Luan-Don/AD5941-EIT-Analyzer/README.md

# AD5941-EIT-Analyzer
This project is based on the previous project "AD5941 Impedance Analyzer" which extends further its application in Electrical Impedance Tomography. This project focuses on making the external PCB board (containing MUX) for AD5941 Impedance Analyzer (AIA for short).
