Luan-Don/AD5941-EIT-Analyzer/docs/weekly_report/AIA_w1.pptx

## MUX Circuit for Electrical Impedance Tomography (EIT) System

Weekly report – W1

## System overview

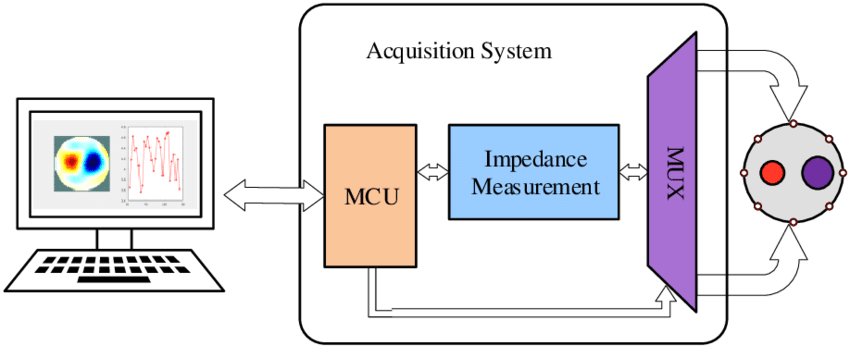
[picture p1: figure]
The block diagram of electrical impedance tomography (EIT) system ...

Fig 1. Block diagram of Electrical impedance tomography (EIT) system (5)

Notes: Mainly consists of 3 main parts: Acquisition system, phantom, host system
Acquisition system includes an MCU, an impedance measurement module and multiplexer circuit.

## Drive pattern: 4-wire measurement using AD5941

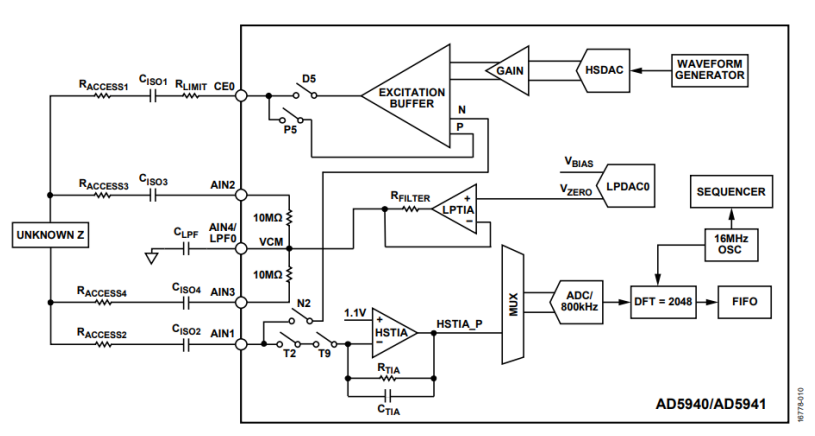
[picture p2: figure]
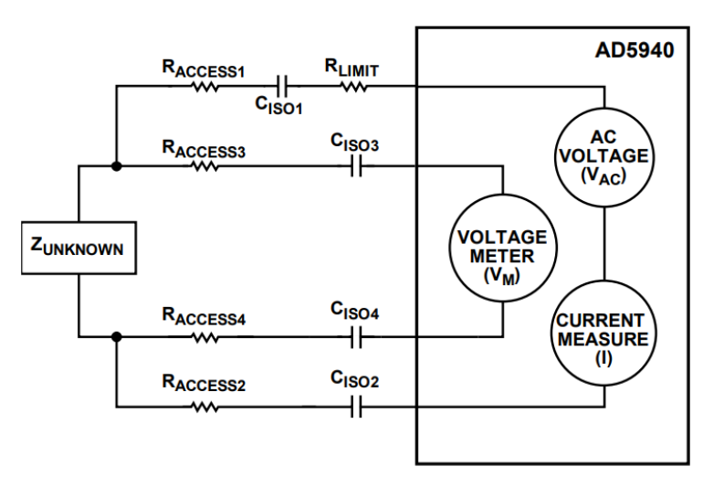
[picture p3: figure]

## Multiplexer (MUX) circuit

-> Require 4 MUX as analog switches

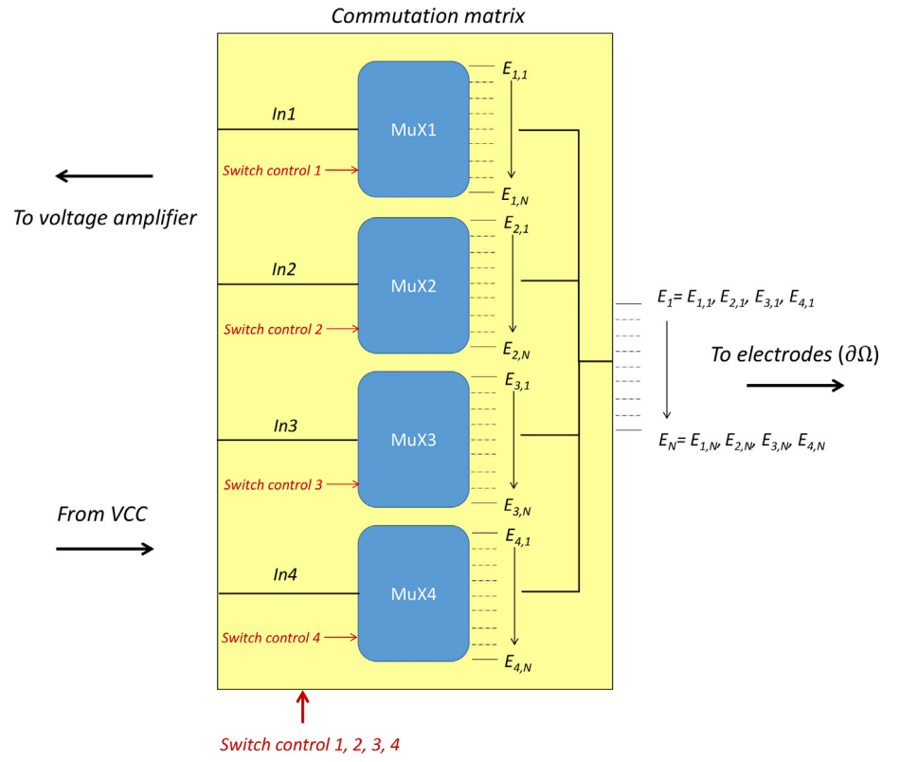
[picture p4: figure]

Controlled by Arduino Mega (4)
ADG506AKRZ – 16 channel
Switching time: <1us

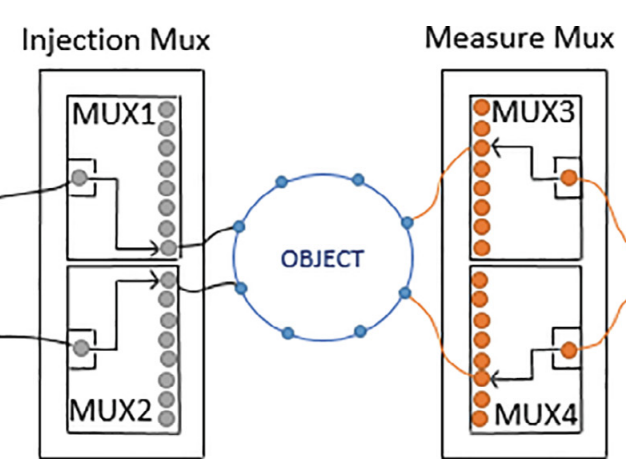
[picture p5: figure]

Controlled by Arduino Mega (1)
74HC4067 – 8 channel

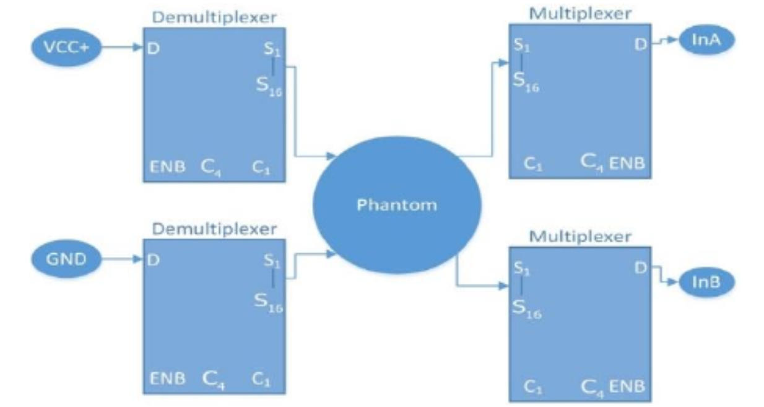
[picture p6: figure]

Controlled by Raspberry Pi (2)
ADG506AKNZ – 16 channel
1ms/data -> 4s/measurement

Notes: 100us

## 4 Current injection methods - Neighboring

Red: current electrodes
Blue: voltage electrodes

the differential potentials are measured across the different electrodes, excluding the current electrodes

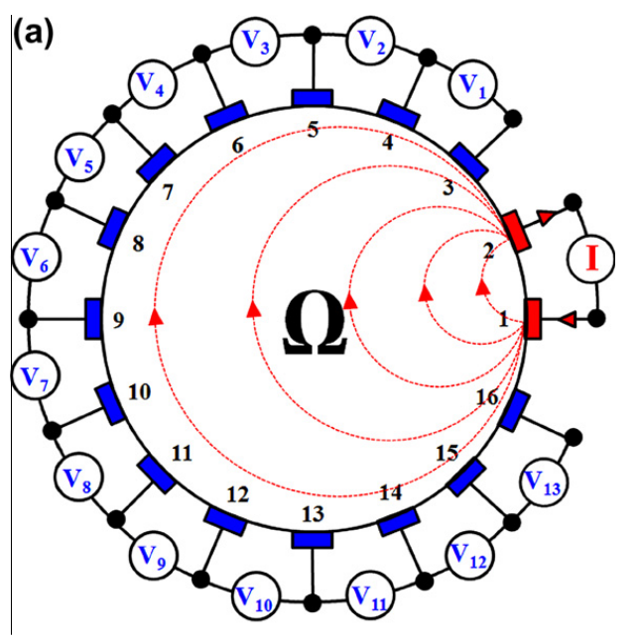
[picture p7: figure]
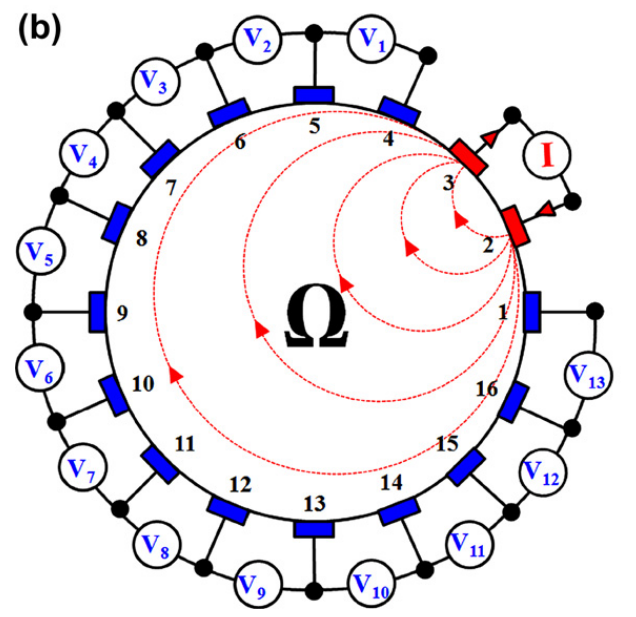
[picture p8: figure]

208 voltage measurement
104 independent data

## 4 Current injection methods - Opposite

Red: current electrodes
Blue: voltage electrodes

Differential potentials are measured on the voltage electrodes with respect to the electrode (called as the voltage reference electrode) adjacent to the current-injecting electrode.

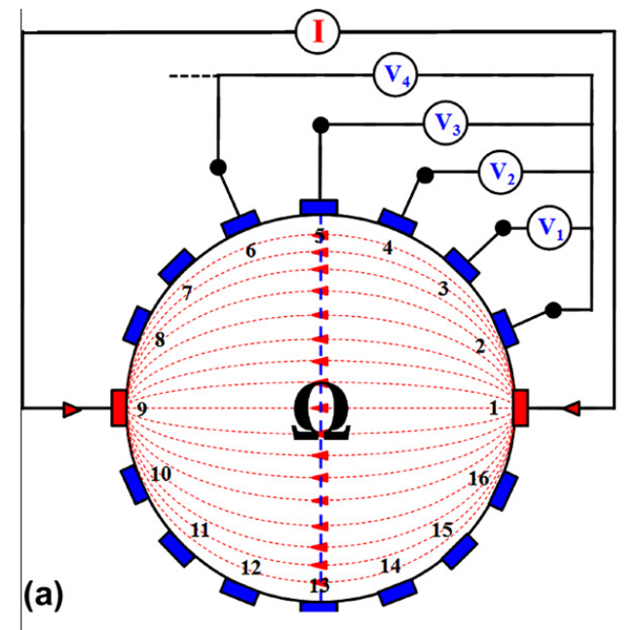
[picture p9: figure]

208 voltage measurement
104 independent data

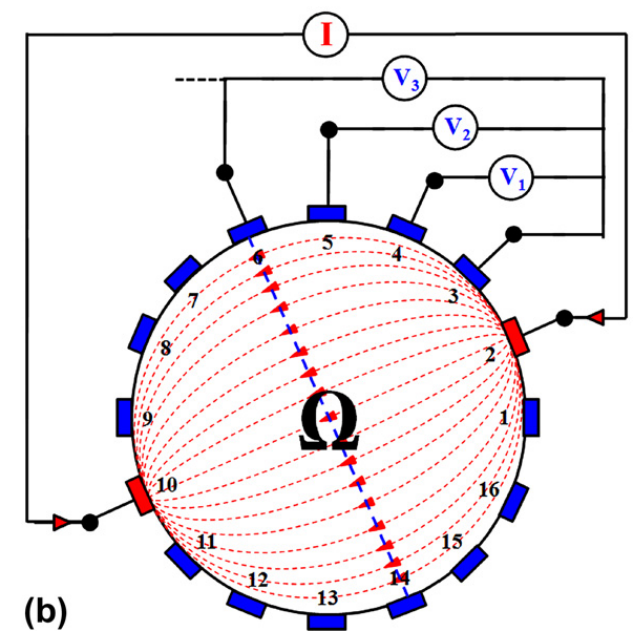
[picture p10: figure]

current distribution is more uniform and, therefore, has a good sensitiviy

## 4 Current injection methods - Cross

Red: current electrodes
Blue: voltage electrodes

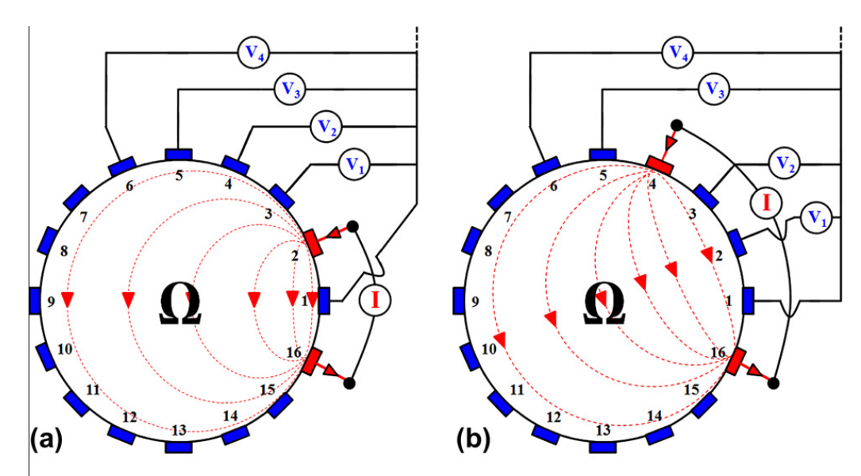
[picture p11: figure]
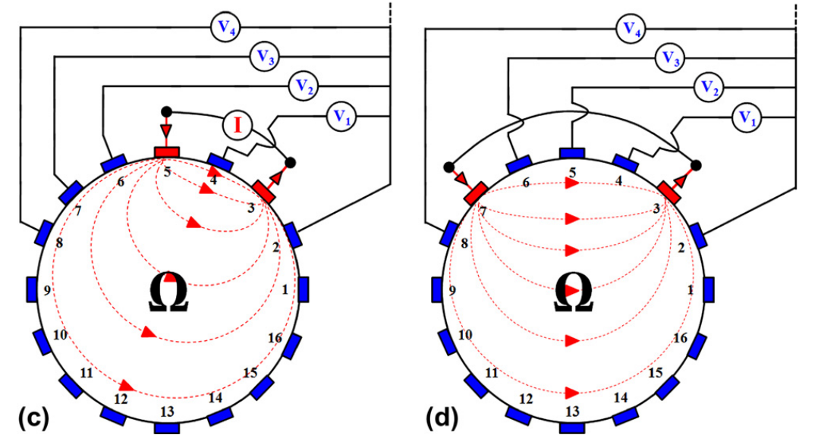
[picture p12: figure]

182 voltage measurement
104 independent data

Does not have as good a sensitivity in the periphery as does the neighboring method, but has better sensitivity over the entire domain under test

## 4 Current injection methods - Adaptive

Red: current electrodes
Blue: voltage electrodes

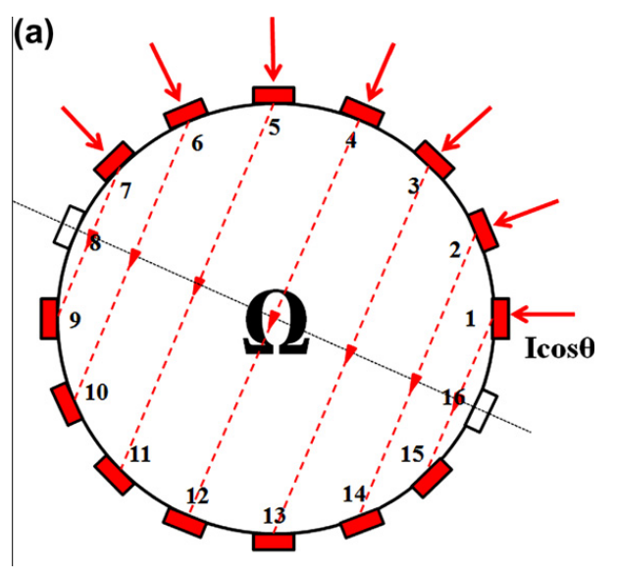
[picture p13: figure]

the boundary potentials are measured with respect to a single grounded electrode

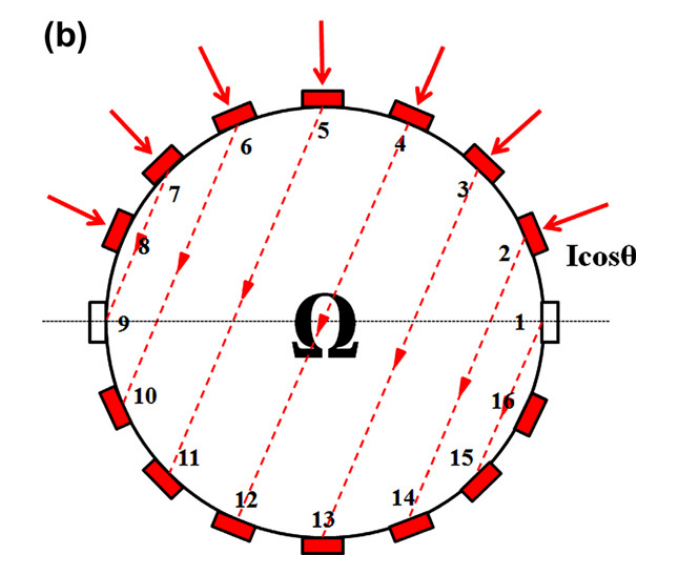
[picture p14: figure]

102 independent data

## Future planning

- Research more about the speed for data acquisition -> to select MUX and MCU to control the MUX

## Reference

- https://www.sciencedirect.com/science/article/pii/S2468067222000190 (https://www.researchgate.net/publication/334773554_Design_of_low-cost_and_high-speed_portable_two-dimensional_electrical_impedance_tomography_EIT)
- ( (https://www.researchgate.net/publication/334773554_Design_of_low-cost_and_high-speed_portable_two-dimensional_electrical_impedance_tomography_EIT)PDF) Design of low-cost and high-speed portable two-dimensional electrical impedance tomography (EIT) (researchgate.net (https://www.researchgate.net/publication/334773554_Design_of_low-cost_and_high-speed_portable_two-dimensional_electrical_impedance_tomography_EIT)) (https://www.researchgate.net/publication/334773554_Design_of_low-cost_and_high-speed_portable_two-dimensional_electrical_impedance_tomography_EIT)
- Studying the resistivity imaging of chicken tissue phantoms with different current patterns in Electrical Impedance Tomography (EIT) (https://www.sciencedirect.com/science/article/pii/S0263224112000036)– (https://www.sciencedirect.com/science/article/pii/S0263224112000036)ScienceDirect (https://www.sciencedirect.com/science/article/pii/S0263224112000036)
- An open-source and easily replicable hardware for Electrical Impedance Tomography (https://www.sciencedirect.com/science/article/pii/S2468067222000232)– (https://www.sciencedirect.com/science/article/pii/S2468067222000232)ScienceDirect (https://www.sciencedirect.com/science/article/pii/S2468067222000232)
- Deep learning scheme (https://www.researchgate.net/publication/350287658_Deep_learning_scheme_PSPNet_for_electrical_impedance_tomography)PSPNet (https://www.researchgate.net/publication/350287658_Deep_learning_scheme_PSPNet_for_electrical_impedance_tomography) for electrical impedance tomography (researchgate.net) (https://www.researchgate.net/publication/350287658_Deep_learning_scheme_PSPNet_for_electrical_impedance_tomography)

## Microcontroller - Requirement

- Have enough GPIO pins to control 4 muxes
Each mux requires 4 control pins (INH, A, B, C) -> Require at least 16 pins + 2 pins for I2C communication
- Have I2C communication
- Low-cost

Notes: Toc do i2c
