Luan-Don/AD5941-EIT-Analyzer/docs/weekly_report/AIA_w3.pptx

## MUX Circuit for Electrical Impedance Tomography (EIT) System

Weekly report – W3

## System overview

The block diagram of electrical impedance tomography (EIT) system ...

Fig 1. Block diagram of Electrical impedance tomography (EIT) system (5)

Notes: Mainly consists of 3 main parts: Acquisition system, phantom, host system
Acquisition system includes an MCU, an impedance measurement module and multiplexer circuit.

## Drive pattern: 4-wire measurement using AD5941

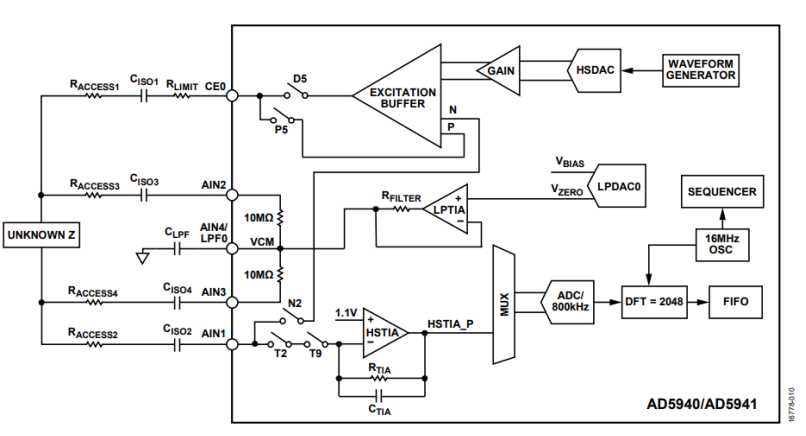
[picture p15: figure]

Accuracy of measured impedance relies on
R_(ACCESS1) , R_(ACCESS2) but not on R_(ACCESS3) , R_(ACCESS4)
- Use HIGH ON-RESISTANCE MUX at voltage electrode (Higher availability, lower cost)
- Use LOW ON-RESISTANCE MUX at current electrode


## Market research

| ADG706BRUZ | CD4067BE | NX3L4051PW-Q100J
MUX circuit | 16:1 | 16:1 | 8:1
Ron (max) | 4.5 Ω | 240 Ω | 0.75 Ω
Δ Ron between channel (max) | | 5 Ω | 0.07 Ω
Switch time (Ton, Toff) | 32ns, 16ns | | 45ns, 25ns
Bandwidth | 25MHz | 14MHz | 15MHz
Price | $105 | $22 (available at our lab) | $23
Delivery day | 14 days | | 21 days
Online store | ADG706BRUZ (ruten.com.tw) (https://www.ruten.com.tw/item/show?22410942692506) | | NX3L4051PW-Q100J (ruten.com.tw) (https://www.ruten.com.tw/item/show?22339779695833)
Datasheet | ADG706/ADG707 (Rev. B) (analog.com) (https://www.analog.com/media/en/technical-documentation/data-sheets/ADG706_707.pdf) | CD40x7B CMOS (https://www.ti.com/lit/ds/symlink/cd4067b.pdf?HQS=dis-dk-null-digikeymode-dsf-pf-null-wwe&ts=1723042470805)Analog (https://www.ti.com/lit/ds/symlink/cd4067b.pdf?HQS=dis-dk-null-digikeymode-dsf-pf-null-wwe&ts=1723042470805) (https://www.ti.com/lit/ds/symlink/cd4067b.pdf?HQS=dis-dk-null-digikeymode-dsf-pf-null-wwe&ts=1723042470805)Multiplexers (https://www.ti.com/lit/ds/symlink/cd4067b.pdf?HQS=dis-dk-null-digikeymode-dsf-pf-null-wwe&ts=1723042470805) or (https://www.ti.com/lit/ds/symlink/cd4067b.pdf?HQS=dis-dk-null-digikeymode-dsf-pf-null-wwe&ts=1723042470805)Demultiplexers (http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 | Single low-ohmic 8-channel analog switch (nxp.com) (https://www.nxp.com/docs/en/data-sheet/NX3L4051.pdf)

## Proposed design: 16-electrode EIT system

Proposed MUX solution:
- 2 1:16 mux, 2 low Ron 1:8 mux
- Cross method, combine both neighboring and opposite method

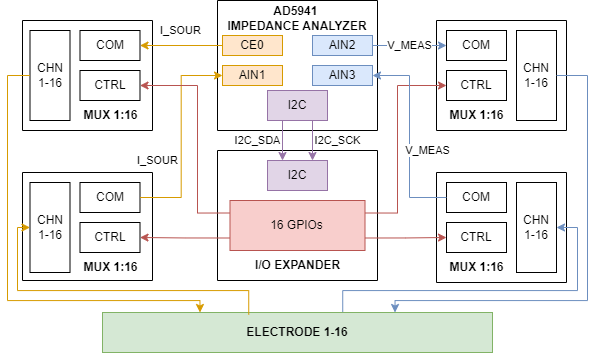
[picture p16: figure]
Ảnh có chứa văn bản, biểu đồ, Kế hoạch, ảnh chụp màn hình Mô tả được tạo tự động

Common MUX solution:
- 4 1:16 mux
- Neighboring method [1,2,3]

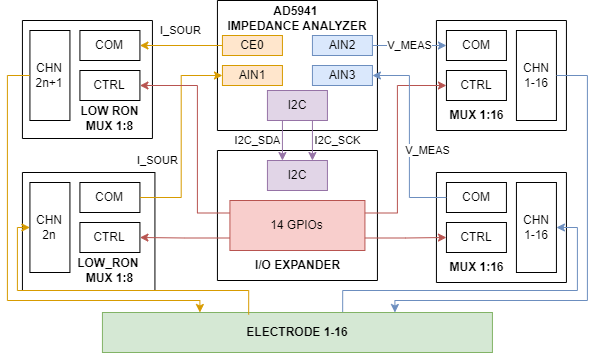
[picture p17: figure]
Ảnh có chứa văn bản, biểu đồ, Kế hoạch, ảnh chụp màn hình Mô tả được tạo tự động

## Current injection – Neighboring method

Red: current electrodes
Blue: voltage electrodes

the differential potentials are measured across the different electrodes, excluding the current electrodes


208 voltage measurement
104 independent data

## Current injection – Opposite method

Red: current electrodes
Blue: voltage electrodes

Differential potentials are measured on the voltage electrodes with respect to the electrode (called as the voltage reference electrode) adjacent to the current-injecting electrode.


208 voltage measurement
104 independent data


current distribution is more uniform and, therefore, has a good sensitivity

## Current injection – Cross method

Adjacent electrodes E16 and E1 are first selected for current and voltage reference electrodes. The 13 voltage data are measured successively for all other 13 electrodes starting from E3. The next 13 voltage data are obtained by injecting by injecting the positive current through E4, keeping E16 as the current reference. The cycle repeats with E3 and E2 as current and voltage reference electrodes.


Red: current electrodes
Blue: voltage electrodes

182 voltage measurement
104 independent data

Does not have as good a sensitivity in the periphery as does the neighboring method, but has better sensitivity over the entire domain under test

## Current injection – Another cross method

Red: current electrodes

Odd-number electrodes are selected for the positive current-injecting electrode (CE0) while even-number electrodes are selected for the negative current-injecting electrode (AIN1). This method requires two 1:8 mux to drive the current electrodes, unlike other method with two 1:16 mux.

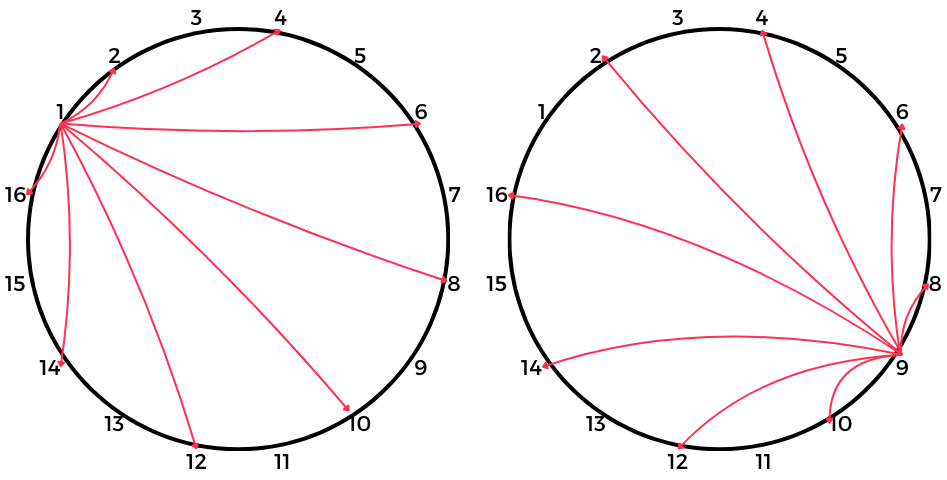
[picture p18: figure]
Ảnh có chứa biểu đồ, vòng tròn, hàng Mô tả được tạo tự động

8 x 16 x 13 = 1664 voltage measurement

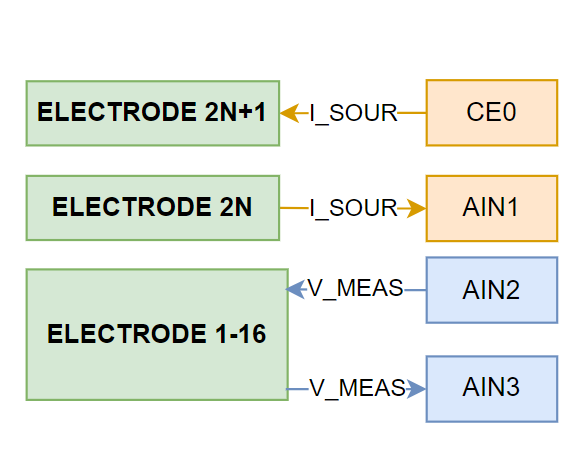
[picture p19: figure]

- Good sensitivity measuring peripheral impedance
- Uniform current distribution

## Proposed schematics

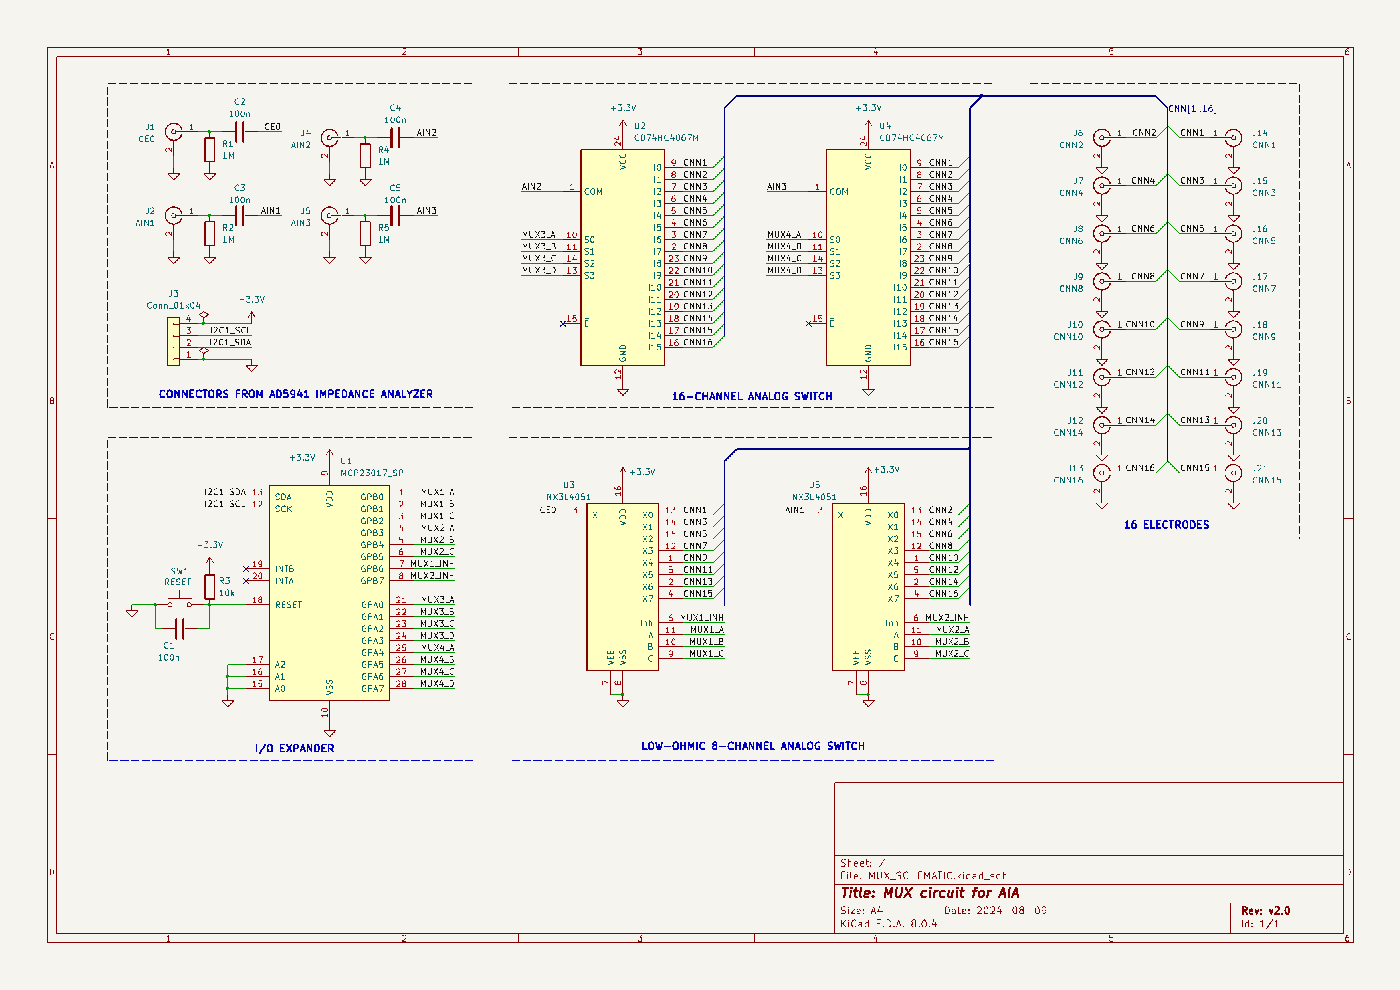
[picture p20: figure]

## Future planning

## Reference

- (PDF) Design of low-cost and high-speed portable two-dimensional electrical impedance tomography (EIT) (researchgate.net) (https://www.researchgate.net/publication/334773554_Design_of_low-cost_and_high-speed_portable_two-dimensional_electrical_impedance_tomography_EIT)
- Studying the resistivity imaging of chicken tissue phantoms with different current patterns in Electrical Impedance Tomography (EIT) – (https://www.sciencedirect.com/science/article/pii/S0263224112000036)ScienceDirect (https://www.sciencedirect.com/science/article/pii/S0263224112000036)
- An open-source and easily replicable hardware for Electrical Impedance Tomography – (https://www.sciencedirect.com/science/article/pii/S2468067222000232)ScienceDirect (https://www.sciencedirect.com/science/article/pii/S2468067222000232)
- Deep learning scheme (https://www.researchgate.net/publication/350287658_Deep_learning_scheme_PSPNet_for_electrical_impedance_tomography)PSPNet (https://www.researchgate.net/publication/350287658_Deep_learning_scheme_PSPNet_for_electrical_impedance_tomography) for electrical impedance tomography (researchgate.net) (https://www.researchgate.net/publication/350287658_Deep_learning_scheme_PSPNet_for_electrical_impedance_tomography)

## Microcontroller - Requirement

- Have enough GPIO pins to control 4 muxes
Each mux requires 4 control pins (INH, A, B, C) -> Require at least 16 pins + 2 pins for I2C communication
- Have I2C communication
- Low-cost

Notes: Toc do i2c
