Luan-Don/AD5941-EIT-Analyzer/hardware/signal_diagram/2nddesign_new_method_electrode_connection.png

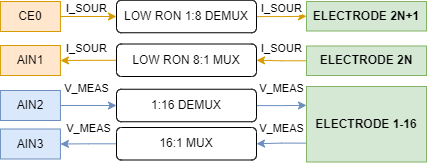
hardware/signal_diagram/2nddesign_new_method_electrode_connection.png
