Luan-Don/AD5941-EIT-Analyzer/hardware/mux_schematic_kicad/MUX_SCHEMATIC.kicad_pcb

## KiCad design hardware/mux_schematic_kicad/MUX_SCHEMATIC.kicad_pcb (2024-07-30)

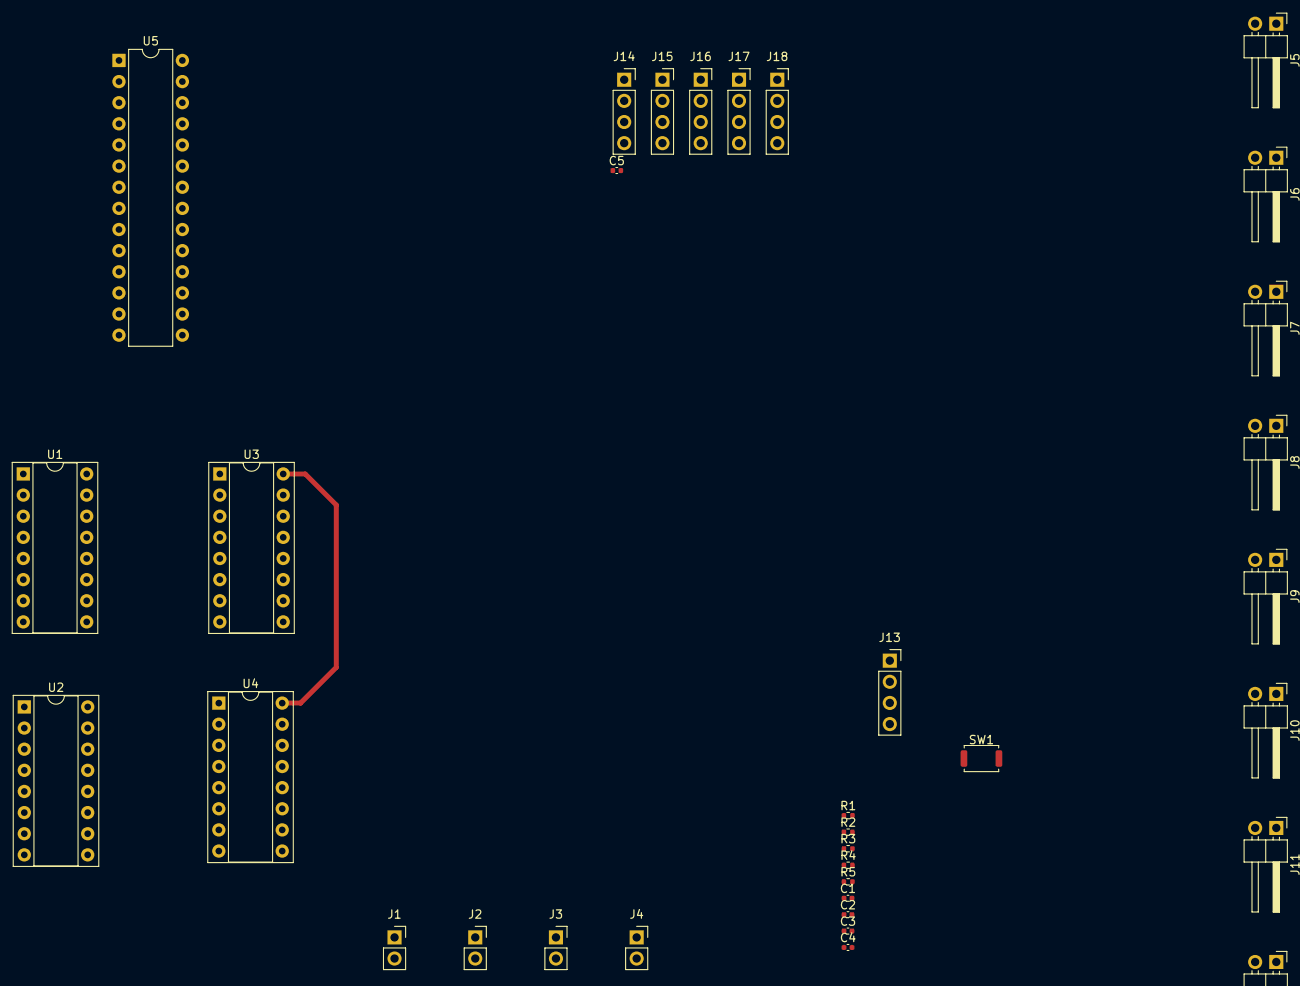
[picture p22: board MUX_SCHEMATIC.kicad_pcb from above]

Board: 2 copper layers, 34 parts (0 on the bottom side), 37 nets.

Parts:
C1, C2, C3, C4, C5: 100n; C_0402_1005Metric
J1: CE0; PinSocket_1x02_P2.54mm_Vertical
J2: AIN1; PinSocket_1x02_P2.54mm_Vertical
J3: AIN2; PinSocket_1x02_P2.54mm_Vertical
J4: AIN3; PinSocket_1x02_P2.54mm_Vertical
J5: CNN1; PinHeader_1x02_P2.54mm_Horizontal
J6: CNN2; PinHeader_1x02_P2.54mm_Horizontal
J7: CNN3; PinHeader_1x02_P2.54mm_Horizontal
J8: CNN4; PinHeader_1x02_P2.54mm_Horizontal
J9: CNN5; PinHeader_1x02_P2.54mm_Horizontal
J10: CNN6; PinHeader_1x02_P2.54mm_Horizontal
J11: CNN7; PinHeader_1x02_P2.54mm_Horizontal
J12: CNN8; PinHeader_1x02_P2.54mm_Horizontal
J13: Conn_01x04; PinSocket_1x04_P2.54mm_Vertical
J14: MUX1_CON; PinSocket_1x04_P2.54mm_Vertical
J15: MUX2_CON; PinSocket_1x04_P2.54mm_Vertical
J16: MUX3_CON; PinSocket_1x04_P2.54mm_Vertical
J17: MUX4_CON; PinSocket_1x04_P2.54mm_Vertical
J18: MUX_COM; PinSocket_1x04_P2.54mm_Vertical
R1: 10k; R_0402_1005Metric
R2, R3, R4, R5: 1M; R_0402_1005Metric
SW1: RESET; SW_Push_SPST_NO_Alps_SKRK
U1, U2, U3, U4: 4051; DIP-16_W7.62mm_Socket
U5: MCP23017_SP; DIP-28_W7.62mm

Connections:
+3.3V: J13.4, R1.1, U1.16 (VDD), U2.16 (VDD), U3.16 (VDD), U4.16 (VDD), U5.9 (VDD)
/CNN1: J5.1 (In), U1.13 (X0), U2.13 (X0), U3.13 (X0), U4.13 (X0)
/CNN2: J6.1 (In), U1.14 (X1), U2.14 (X1), U3.14 (X1), U4.14 (X1)
/CNN3: J7.1 (In), U1.15 (X2), U2.15 (X2), U3.15 (X2), U4.15 (X2)
/CNN4: J8.1 (In), U1.12 (X3), U2.12 (X3), U3.12 (X3), U4.12 (X3)
/CNN5: J9.1 (In), U1.1 (X4), U2.1 (X4), U3.1 (X4), U4.1 (X4)
/CNN6: J10.1 (In), U1.5 (X5), U2.5 (X5), U3.5 (X5), U4.5 (X5)
/CNN7: J11.1 (In), U1.2 (X6), U2.2 (X6), U3.2 (X6), U4.2 (X6)
/CNN8: J12.1 (In), U1.4 (X7), U2.4 (X7), U3.4 (X7), U4.4 (X7)
/GPA0: J14.1, U1.6 (Inh), U5.21 (GPA0)
/GPA1: J14.2, U1.11 (A), U5.22 (GPA1)
/GPA2: J14.3, U1.10 (B), U5.23 (GPA2)
/GPA3: J14.4, U1.9 (C), U5.24 (GPA3)
/GPA4: J15.1, U2.6 (Inh), U5.25 (GPA4)
/GPA5: J15.2, U2.11 (A), U5.26 (GPA5)
/GPA6: J15.3, U2.10 (B), U5.27 (GPA6)
/GPA7: J15.4, U2.9 (C), U5.28 (GPA7)
/GPB0: J16.1, U3.6 (Inh), U5.1 (GPB0)
/GPB1: J16.2, U3.11 (A), U5.2 (GPB1)
/GPB2: J16.3, U3.10 (B), U5.3 (GPB2)
/GPB3: J16.4, U3.9 (C), U5.4 (GPB3)
/GPB4: J17.1, U4.6 (Inh), U5.5 (GPB4)
/GPB5: J17.2, U4.11 (A), U5.6 (GPB5)
/GPB6: J17.3, U4.10 (B), U5.7 (GPB6)
/GPB7: J17.4, U4.9 (C), U5.8 (GPB7)
/I2C1_SCL: J13.3, U5.12 (SCK)
/I2C1_SDA: J13.2, U5.13 (SDA)
/MUX1_COM: C1.2, J18.1, U1.3 (X)
/MUX2_COM: C2.2, J18.2, U2.3 (X)
/MUX3_COM: C3.2, J18.3, U3.3 (X)
/MUX4_COM: C4.2, J18.4, U4.3 (X)
GND: C5.1, J1.2 (Ext), J2.2 (Ext), J3.2 (Ext), J4.2 (Ext), J5.2 (Ext), J6.2 (Ext), J7.2 (Ext), J8.2 (Ext), J9.2 (Ext), J10.2 (Ext), J11.2 (Ext), J12.2 (Ext), J13.1, R2.2, R3.2, R4.2, R5.2, SW1.1, U1.7 (VEE), U1.8 (VSS), U2.7 (VEE), U2.8 (VSS), U3.7 (VEE), U3.8 (VSS), U4.7 (VEE), U4.8 (VSS), U5.10 (VSS), U5.15 (A0), U5.16 (A1), U5.17 (A2)
unnamed: C1.1, J1.1 (In), R2.1
unnamed: C2.1, J2.1 (In), R3.1
unnamed: C3.1, J3.1 (In), R4.1
unnamed: C4.1, J4.1 (In), R5.1
unnamed: C5.2, R1.2, SW1.2, U5.18 (~RESET)
