Luan-Don/AD5941-EIT-Analyzer/(commit log)

2024-07-30 hw: add schematics, docs (8 channel, io expander)
    [MUX_SCHEMATIC.kicad_pcb, MUX_SCHEMATIC.kicad_sch]
2024-08-15 new signal diagram, new measuring pattern
    [MUX_SCHEMATIC.kicad_sch]
2024-08-15 update schematic with new design (v2.0)
    [MUX_SCHEMATIC.kicad_sch]
